aydin-ege/High-Voltage-Generator/Geiger-Müller Tube experiments/Qfaces.png

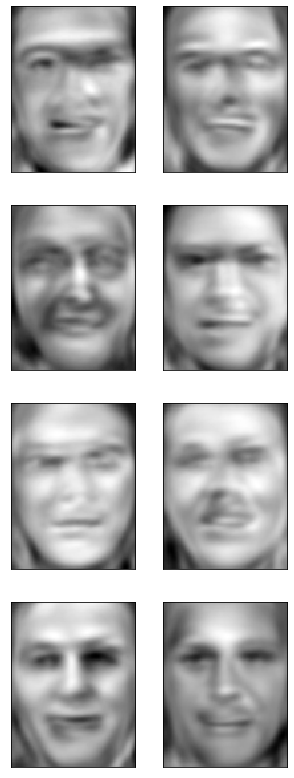
Geiger-Müller Tube experiments/Qfaces.png
