aydin-ege/High-Voltage-Generator/Geiger-Müller Tube experiments/Geiger.PNG

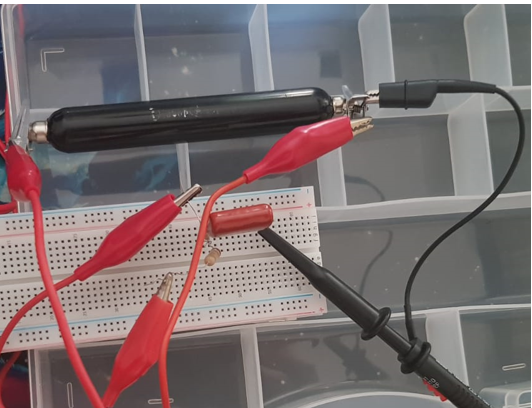
Geiger-Müller Tube experiments/Geiger.PNG
