aydin-ege/High-Voltage-Generator/README.md

# High-Voltage-Generator
An improved ZVS circuit on PCB with a safety oriented design that generates 400V from low voltage DC for the purposes of operating a Geiger-Müller Tube

Check EEE313 Course Project Report.pdf and PHYS212_Final_Report.pdf for more info.
