aydin-ege/High-Voltage-Generator/Geiger-Müller Tube experiments/CDF.png

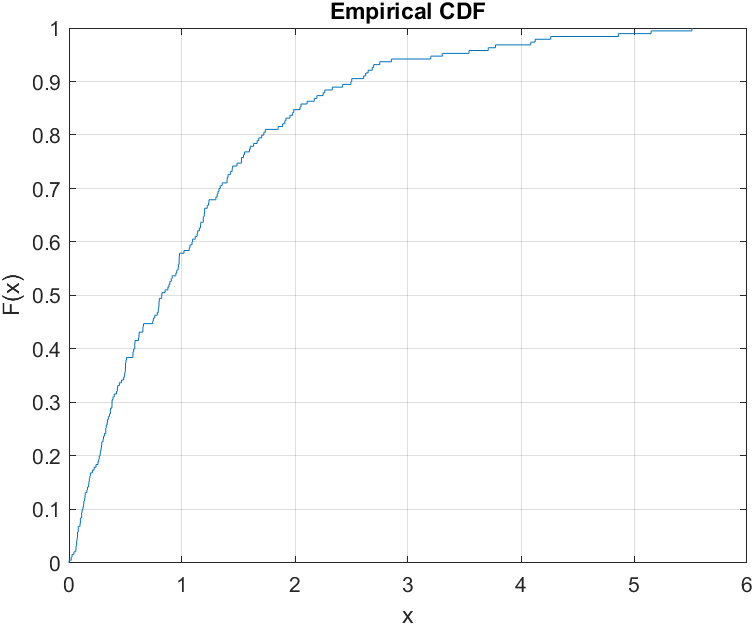
Geiger-Müller Tube experiments/CDF.png
