aydin-ege/High-Voltage-Generator/Geiger-Müller Tube experiments/circ.png

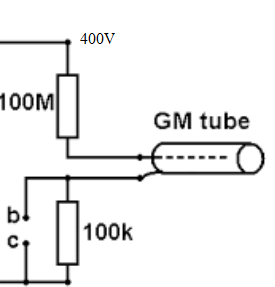
Geiger-Müller Tube experiments/circ.png
