aydin-ege/High-Voltage-Generator/Geiger-Müller Tube experiments/Untitled.png

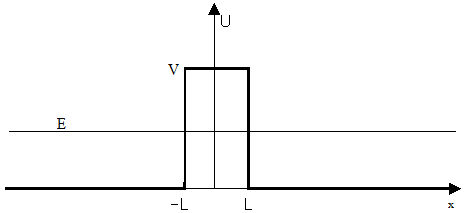
Geiger-Müller Tube experiments/Untitled.png
