aydin-ege/High-Voltage-Generator/(list of files, drawings)

Other design files:
PCB/dtZVS.dip
