aydin-ege/High-Voltage-Generator/ZVS.kicad_pcb

## KiCad design ZVS.kicad_pcb (2021-10-26)

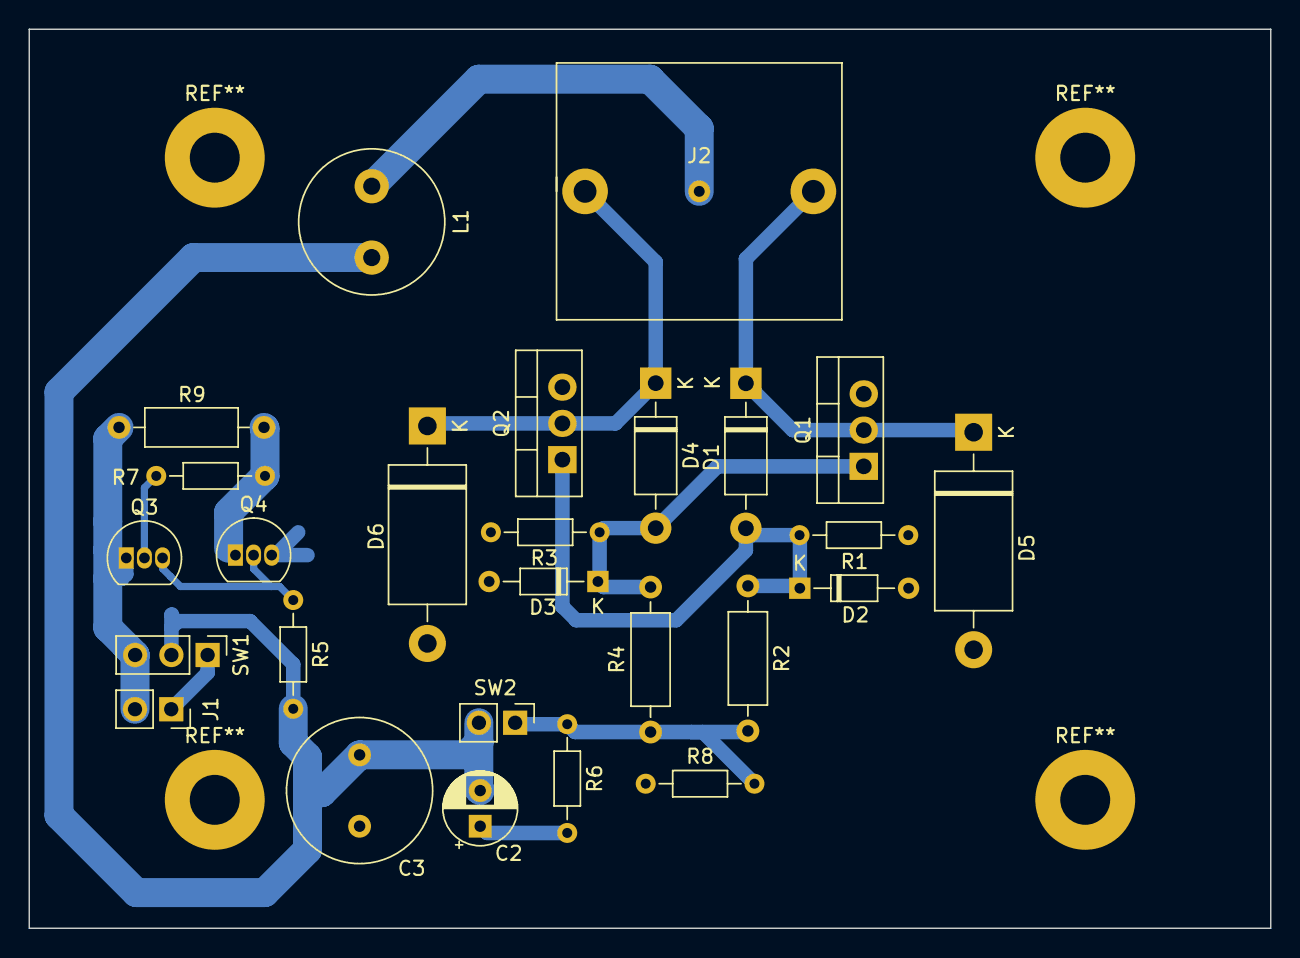
[picture p30: board ZVS.kicad_pcb from above]

Board: 2 copper layers, 87.0 x 63.0 mm, 26 parts (0 on the bottom side), 14 nets.

Parts:
C2: 1u; CP_Radial_D5.0mm_P2.50mm
C3: 1000u; C_Radial_D10.0mm_H16.0mm_P5.00mm
D1, D4: 1N5819; D_DO-41_SOD81_P10.16mm_Horizontal
D2, D3: 3V9; D_DO-34_SOD68_P7.62mm_Horizontal
D5, D6: 1N53xxB; D_DO-201_P15.24mm_Horizontal
J1: Conn_01x02; PinSocket_1x02_P2.54mm_Vertical
J2: Conn_01x03; Transformer_HV
L1: 47u; L_Radial_D10.0mm_P5.00mm_Neosid_SD12k_style3
Q1, Q2: IRLZ44N; TO-220-3_Vertical
Q3, Q4: 2N3904; TO-92_Inline
R1, R3: 50k; R_Axial_DIN0204_L3.6mm_D1.6mm_P7.62mm_Horizontal
R2, R4: 56; R_Axial_DIN0207_L6.3mm_D2.5mm_P10.16mm_Horizontal
R5: 570; R_Axial_DIN0204_L3.6mm_D1.6mm_P7.62mm_Horizontal
R6: 10; R_Axial_DIN0204_L3.6mm_D1.6mm_P7.62mm_Horizontal
R7, R8: 1k; R_Axial_DIN0204_L3.6mm_D1.6mm_P7.62mm_Horizontal
R9: 0.1; R_Axial_DIN0207_L6.3mm_D2.5mm_P10.16mm_Horizontal
SW1: SW_SPDT; PinHeader_1x03_P2.54mm_Vertical
SW2: SW_Push; PinHeader_1x02_P2.54mm_Vertical

Connections:
+4V: C2.2, C3.1, L1.2, R5.2, SW1.2, SW2.2
-BATT: J1.2, Q3.1, R9.2, SW1.3
/CENTER_TAP: J2.2, L1.1
/ENABLE: R2.2, R4.1, R6.1, R8.2, SW2.1
/GATE_L: D3.1, D4.2, Q1.1, R3.2, R4.2
/GATE_R: D1.2, D2.1, Q2.1, R1.2, R2.1
/TANK_L: D1.1, D5.1, J2.3, Q1.2
/TANK_R: D4.1, D6.1, J2.1, Q2.2
GND: C3.2, D2.2, D3.2, D5.2, D6.2, Q1.3, Q2.3, Q4.3, R1.1, R3.1, R8.1
unnamed: C2.1, R6.2
unnamed: J1.1, SW1.1
unnamed: Q3.2, R7.1
unnamed: Q3.3, Q4.2, R5.1
unnamed: Q4.1, R7.2, R9.1
